robertoostenveld/esp8266_artnet_dmx512/(threads)

Thread 4 (2022-11-02):

i2s includes are case sensitive

apdlv72, 2022-11-02:
I didn't want to create a pull request for this tiny thing.
I noticed that upper/lower case matters when including the i2s header files.
On my Ubuntu 20.04 / Arduino 1.8.16 compilation fails when using upper.
I had to replace it like follows to fix that:
#include <i2s.h>
#include <i2s_reg.h>

robertoostenveld, 2022-11-02:
bummer! In your PR you used lowercase, but I actually got the error with lowercase and had to change to uppercase. This probably relates to us having different operating systems with different ways of dealing with case-sensitive files. I am using macOS.

In https://github.com/esp8266/Arduino/tree/master/libraries/I2S/src and on my computer `./packages/esp8266/hardware/esp8266/3.0.2/libraries/I2S/src/I2S.h` I see that `I2S.h` is  uppercase. That is also the case for the `./packages/SODAQ/hardware/samd/1.8.9/libraries/I2S/src/I2S.h` on my computer.

I also see that the file `./packages/esp8266/hardware/esp8266/3.0.2/tools/sdk/include/i2s_reg.h` is in lowercase. In the code I had that in uppercase, which worked, but now changing it to lowercase also works.

But when I change `I2S.h` into lowercase, I get

```
...
Alternatives for i2s.h: []
ResolveLibrary(i2s.h)
  -> candidates: []
esp8266_artnet_dmx512:92:10: fatal error: i2s.h: No such file or directory
   92 | #include <i2s.h>
      |          ^~~~~~~
compilation terminated.
```

robertoostenveld, 2022-11-02:
The lowercase `i2s_reg.h` is here https://github.com/esp8266/Arduino/tree/master/tools/sdk/include in the original repository.

robertoostenveld, 2022-11-02:
if you only change `i2s_reg.h` into lowercase (as I just did - and pushed), does it then work for you?

apdlv72, 2022-11-02:
Thank you for chasingthis.
Now I found the issue. It had an older version of the esp8266 package as well as I2S library to the newest versions 3.0.2 and 1.2.1 resp. , it compiles with these includes:
#include <I2S.h>
#include <i2s_reg.h>

Closed 2022-11-02.

Thread 6 (2022-11-02):

ESP32 Support

aaron-harvey, 2022-11-02:
I stumbled across your project today and it looks promising!

Have you considered using an esp32 over the 8622?

robertoostenveld, 2022-11-03:
At the time I initially needed this (around [2016/2017](https://robertoostenveld.nl/?s=dmx512)) the ESP32 had just been released, was not widely supported wrt Arduino libraries, and was not very affordable yet. I personally did not have the need to upgrade the few Artnet-to-dmx converters that I built myself, and am not regularly making new ones. That said, if I were now to start from scratch, it is likely that I would use an ESP32 based board.

Considering my code, I don't think that there is much (if any) that is specific to the ESP8266. The WiFi works the same between the ESP32 and the ESP8266, the LEDs are trivial, the serial/UART output should work fine, and the recently introduced I2S should also work on the ESP32. I suggest you just give it a try to see whether it compiles for and executes on an ESP32 board, even without connecting anything to it.

VocasoGK, 2022-11-09:
I've tried compiling the code with Arduino IDE 2.0.1, with DOIT ESP32 DEVKIT V1, and it doesn't compile. I've tried 'fixing' the code since actually don't really know what I'm doing lol.

Change includes:
- Changing #include from ESP8266 to ESP32 equivalent library.
- Adding #include for SPIFFS lib both in .ino and webinterface.cpp
- Commenting #define ENABLE_UART because I don't know the equivalent of "c_types.h" and "eagle_soc.h"
- Changing #include "uart_register.h" to "soc/uart_reg.h", "i2s.h" to "driver/i2s.h", and "i2s_reg.h" to "soc/i2s_reg.h"
- Changing some part of handleDirList() in webinterface.cpp according to ESP32 SPIFFS syntax. (I hope it has the same functionality)
- Commenting some part in webinterface.cpp that uses Update.

Known problems:
- allBlack() not defined
- Update in webinterface.cpp is not defined
- i2s_begin and i2s_set_rate is not declared

It's a pretty advanced code for me, so yeah. I hope we can get ESP32 support soon as it is substantially more powerful, not to mention the external antenna capabilities on some models. :)
Modified code:
[esp8266_artnet_dmx512.zip](https://github.com/robertoostenveld/esp8266_artnet_dmx512/files/9969300/esp8266_artnet_dmx512.zip)

Thread 8 (2023-03-12):

Wired lan

lhvandersteen, 2023-03-12:
Hello.

Is there a option to use a wired connection instead of wireless.

Thank you

robertoostenveld, 2023-03-12:
In principle yes, but then you should implement it with an arduino or other microcontroller board with a wired ethernet interface. Then you would get something similar as https://www.enttec.com/product/din/ethernet-to-dmx-rdm-adapter/

The esp8266 is a wifi microcontroller module and not suited for wired network, so my design is not of use.

lhvandersteen, 2023-03-12:
Hello

Thank you for the quick answer.
Would this also be working
https://www.olimex.com/Products/IoT/ESP32/ESP32-POE-ISO/open-source-hardware

robertoostenveld, 2023-03-12:
Yes, that might work. Or an Arduino Uno with an [Ethernet Shield](https://docs.arduino.cc/retired/getting-started-guides/ArduinoEthernetShield), or an Adafruit Feather with the [FeatherWing](https://www.adafruit.com/product/3201). But none of them will work with the firmware that is in this repository; they all would require a significant rewrite. I think that - at best - 25% of the code in my repository would be reusable, the rest would probably have to be written from scratch.

Closed 2023-03-12.

Thread 9 (2023-03-23):

why use uart

lesleylemmens, 2023-03-23:
Hi, if i2s works better, why do i need to also make the uart connection and the toggle switch?
in wich file do i enable i2s?

robertoostenveld, 2023-03-23:
There have been reports by some that i2s works good for them, by others (including myself) that uart works good for them. It is a choice that you can make. If you add the toggle switch, you can easily compare. Without the toggle switch you'll have to use a soldering iron to switch between the two options.

In line 37 and 46 of [esp8266_artnet_dmx512.ino](https://github.com/robertoostenveld/esp8266_artnet_dmx512/blob/main/esp8266_artnet_dmx512.ino) you can enable/disable the two options. By default both are enabled; this comes at the expense of slightly higher computational load for the microprocessor, so if you know that you will only be using one you can disable the other.

Thread 11 (2023-04-19):

Static IP setting

maximbeliveau, 2023-04-19:
it would be usefull if we can set a static ip for networks without DHCP servers.

robertoostenveld, 2023-04-19:
That could indeed be useful. For that the code on line https://github.com/robertoostenveld/esp8266_artnet_dmx512/blob/57212159923df2f84f8e9a81104d06b9ad493831/esp8266_artnet_dmx512.ino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 and all other lines relating to the WiFimanager would have to be modified into something like this https://randomnerdtutorials.com/esp32-static-fixed-ip-address-arduino-ide/. It would make the code much simpler.

Making it user-friendly and configurable from the web interface however would better be implemented in the https://github.com/tzapu/WiFiManager package. You can check over there whether it is on the wish-list, or make an issue at https://github.com/tzapu/WiFiManager/issues to suggest this.

I have no plans to implement this myself, so I will close this issue. Feel free to fork my repo and make the change yourself.

meowde, 2023-05-16:
Following up, @robertoostenveld just letting you know that it was indeed already implemented in the WiFiManager package. We added, where you pointed :

wifiManager.setSTAStaticIPConfig(IPAddress(192, 168, 0, 101), IPAddress(192, 168, 0, 1), IPAddress(255, 255, 255, 0));
wifiManager.setShowStaticFields(true);

to have a built-in static IP, and also be able to modify that IP in the Manager afterwards. Thank you!

Closed 2023-04-19.

Thread 12 (2023-09-09):

Not able to receive Artnet packets

woutwoot, 2023-09-09:
I've built this device and connected it to a simple par light to test it. (I2S mode)

It looks like everything is working, but it seems somehow I'm not able to have the ESP receive data over ArtNet.
I'm using QLC+ to send data, and it reports 1000s of packets sent, but on the web interface of the ESP I only see a very low number of packets received (around 30, does go up very very slowly over time)
I can tell the light itself is receiving DMX data because it has a blinking led for this.

I would really love to get this to work but at this point I'm not sure if I'm doing something wrong or what it may be. Any clue as to what this issue could be or how I could debug it?

robertoostenveld, 2023-09-09:
I suggest you use the serial monitor in the Arduino IDE to connect to the ESP. On this line https://github.com/robertoostenveld/esp8266_artnet_dmx512/blob/57212159923df2f84f8e9a81104d06b9ad493831/esp8266_artnet_dmx512.ino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 it will print that it receives data and a bit further it will print a counter for the number of Artnet packets received. That should help you to further debug.

robertoostenveld, 2023-09-09:
Oh, and the DMX stream that your fixture receives is sent by the ESP independently of the Artnet that it receives. In the main loop on line https://github.com/robertoostenveld/esp8266_artnet_dmx512/blob/57212159923df2f84f8e9a81104d06b9ad493831/esp8266_artnet_dmx512.ino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 and a bit further it sends the data of the whole universe over the serial interface, at a fixed rate. The ‎onDmxPacket‎() function only runs when an UDP packet is received and it updates the universe data.

woutwoot, 2023-09-10:
@robertoostenveld Thank you for pointing me in the right direction. Of course it was something stupid, I was using Artnet universe 0 in QLC+ and universe 1 is what my light setup was responding to. As soon as the two matched things worked.
Thank you for this project!

woutwoot, 2023-09-10:
Hmm, is it possible that somehow addresses are also shifted by one? My fixture starts at 1 but it seems my first channel is shifted one up in practice. Guess that's something on my end as well but just making sure :)

robertoostenveld, 2023-09-11:
With the numbered universes and channels it can be challenging to deal with the numbering sometimes starting at 0, and sometimes at 1. Glad you figured it out and have fun with it!

Closed 2023-09-10.

Thread 13 (2023-10-12):

Problem uploading web page

lightsun1323, 2023-10-12:
After uploading the project, I encountered the problem that none of the web pages in the data folder were uploaded, except for the ones in the photo below.
Where do you think the problem comes from?
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

robertoostenveld, 2023-10-15:
As long as you see this, it is not connected to wifi and it remains basically stuck in the `setup()` function around https://github.com/robertoostenveld/esp8266_artnet_dmx512/blob/57212159923df2f84f8e9a81104d06b9ad493831/esp8266_artnet_dmx512.ino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

I am not exactly sure at which line it blocks, but it won't get  to https://github.com/robertoostenveld/esp8266_artnet_dmx512/blob/57212159923df2f84f8e9a81104d06b9ad493831/esp8266_artnet_dmx512.ino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 where the webserver with all other pages is initiated.

Have you connected the ESP8266 over the serial/usb port to your computer. If you use the Arduino serial monitor, you can follow in much more detail what happens in the code with the `Serial.println()` lines.

Thread 14 (2023-10-12):

Changing the base of the signal output

lightsun1323, 2023-10-12:
I am using esp8266-07 and after uploading the RX base project, it is the output base
I want to make changes so that the TX base is the DMX output base
I changed the LED bases according to what I want, but I did not find the DMX output base
Is such a thing possible or not?

robertoostenveld, 2023-10-15:
I am not really sure what you mean with "base", it is not a term that I am familiar with in relation to this microcontroller or the arduino environment.

There are two modes of operation, either it uses the serial UART1 through `Serial1` (when `ENABLE_UART` is defined, see line 37), or it uses I2S which is the sound interface (when `ENABLE_I2S` is defined, see line 46).

See http://arduino.esp8266.com/Arduino/versions/2.3.0/doc/reference.html#serial for documentation on the serial interface.

If you don't want to use UART1, I suggest you use the I2S interface. That is explained [here](https://github.com/robertoostenveld/esp8266_artnet_dmx512/blob/main/README.md#i2s).

I should add that I have implemented this for a Wemos D1 mini board and only tested that and a NodeMCU module. The ESP-07 is a more bare module that seems to have fewer pins exposed. The sketch may need changes to accommodate
that.

lightsun1323, 2023-10-15:
Forgive me for my wrong translation
By the base, I mean the pin
I defined all the pins for esp07 and the project is running well
The only problem I have is that the RX pin is recognized as an output on I2S, and no matter what I did, I could not change it to the TX pin.

Regards
Sami

robertoostenveld, 2023-10-15:
There is no dedicated pin for I2S (see https://docs.espressif.com/projects/esp-idf/en/latest/esp32/api-reference/peripherals/i2s.html), but in my sketch it is set to pin GPIO 3, which is indeed Rx.

See
https://github.com/robertoostenveld/esp8266_artnet_dmx512/blob/57212159923df2f84f8e9a81104d06b9ad493831/esp8266_artnet_dmx512.ino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

As far as I know, you can change it to whatever you like and hence use another pin for I2S.

robertoostenveld, 2023-10-15:
On https://randomnerdtutorials.com/esp8266-pinout-reference-gpios/ there is a section that discusses what the best pins are for certain purposes. You could check there to see which of your ESP-07 pins are still available and are the best suited for output without interfering with other functions.

lightsun1323, 2023-10-15:
I looked at the links you sent
And by changing the number of the pin, nothing happens inside the output and only the RX pin gives the DMX output, even with the number changed
I erase esp07 flash memory with python for each test
I even tested it on the NodeMCU board, but nothing happens by changing the pin and compiling, and even by putting a different number (1, 2, 3, ...), only the RX pin outputs.

lightsun1323, 2023-10-18:
I looked at the links you sent
And by changing the number of the pin, nothing happens inside the output and only the RX pin gives the DMX output, even with the number changed
I erase esp07 flash memory with python for each test
I even tested it on the NodeMCU board, but nothing happens by changing the pin and compiling, and even by putting a different number (1, 2, 3, ...), only the RX pin outputs.

robertoostenveld, 2023-10-20:
I am not sure how you are testing this, do you have a DMX light fixture attached to the ESP, or are you looking with an oscilloscope?  "Nothing happens" (as you write) can be because of a lot of different reasons when you change something, for example because nothing happened to start with.

 I recommend that you make a very simple schematic like a [blink](https://www.arduino.cc/en/Tutorial/BuiltInExamples/Blink) sketch and implement that with the different ways of outputting a PWM series of pulses (which is similar to what the DMX protocol does) and look at that with an LED over a resistor.

Thread 16 (2024-03-10):

no dmx data received by led par

wannabeadjeo, 2024-03-10:
I am using the i2s to send the dmx data to my par, and I wired the di pin to the Rx pin on my nodemcu esp8266, the gnd and re pin on the nodemcu gnd pin, and the vcc to the vv pin on my node mcu. I configured it on the web server, the artnet universe is univ1, the same on my qlc+, the channels are 512, the delay is 25, yet my par is not responding, but if I use my usb to dmx interface, it is working properly.
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

robertoostenveld, 2024-03-10:
Did you try it with the UART mode? Do you have the possibility to connect the output to an oscilloscope to see whether you see a signal?

wannabeadjeo, 2024-03-11:
> Did you try it with the UART mode? Do you have the possibility to connect the output to an oscilloscope to see whether you see a signal?

The problem is that I don't have an oscilloscope to use. I have a question: if I will use the UART mode, do I need to put the di pin on the D4 instead of the tx pin on my Nodemcu?

wannabeadjeo, 2024-03-11:
Sir, you can close this issue. I have found the solution; I just swapped my RS485 module.

robertoostenveld, 2024-03-11:
That is nice to hear, have fun with the DMX converter!

wannabeadjeo, 2024-03-11:
> That is nice to hear, have fun with the DMX converter!

Thank you so much for answering me

Closed 2024-03-11.
