robertoostenveld/esp8266_artnet_dmx512/(commit log)

2017-04-17 first working version of Artnet-DMX512 relay, mpstly based on esp8266_artnet_neopixel
2017-04-17 added some comments to the code, updated RGB led pins
2017-04-20 added configuration option for numbver of channels and for delay between sending of DMX frames (was 512 and 25). With smaller values (e.g. 8 channels, 10ms delay) the responsiveness of my test DMX fi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
    [esp8266_artnet_dmx512.ino]
2017-05-26 better description of led colors
2017-06-08 RE should go to ground
    thanks to Silvano for reporting
2017-08-05 Added an option to use a common anode RGB LED.
2017-08-22 Added C++ code to generate the break on the uart. Initialize the WiFi hostname before starting the network.
2017-11-04 include enclosure, barrel connector and wiring for RGB led in documentation
2017-11-04 removed the LDO regulator
    It is not used in the final design, since the Wemos D1 mini 5V pin can be used
2018-06-12 fixed small typo in a comment
    [esp8266_artnet_dmx512.ino]
2019-09-18 * update ArduinoJson version 5 => 6
2022-09-24 add VCC-to-3.3V for the MAX485 module, reformatted a bit
2022-09-26 Added test code and fixed issues
    [esp8266_artnet_dmx512.ino]
2022-09-27 Update esp8266_artnet_dmx512.ino
    Enabled UART, disabled I2S by default
2022-10-31 merged non-repeating code for I2S and UART into main sketch
2022-10-31 moved status LED handling to separate files
2022-10-31 code cleanup, this commit should not have any major functional changes
    - put code inline where possible
    - avoid functions that are called only once
    - reordered conditional sections of code
    - moved LED handling to separate files
    - renamed setup_ota to webserver
    [esp8266_artnet_dmx512.ino]
2022-10-31 added schematic from https://github.com/robertoostenveld/esp8266_artnet_dmx512/pull/1
2022-11-02 Updated schematic and Readme
2022-11-02 Fixed pin name
2022-11-02 Fixed i2s includes. Simplified rgb_led.cpp
    [esp8266_artnet_dmx512.ino]
2022-11-02 fix #4 - include i2s_reg.h as lowercase file name
    [esp8266_artnet_dmx512.ino]
2022-11-02 Fixed i2s case sensitivity issue
    [esp8266_artnet_dmx512.ino]
2024-02-25 ENH - make explicit that N_JSON_TO_CONFIG, N_CONFIG_TO_JSON, and N_KEYVAL_TO_CONFIG are for numbers
    - there are corresponding S_ versions for strings
    - removed/moved header includes for consistency
    - warn in readme that Arduino IDE 2.x cannot write SPIFFS
2024-03-02 ENH - avoid redirects to make the webinterface faster
    - use server.onNotFound(handleNotFound) for all regular html files, including settings, monitor and hello
    [esp8266_artnet_dmx512.ino, webinterface.cpp]
2024-03-02 ENH - improved consistency
    - wait 5 seconds after reset so that success+reload completes
    - use ESP.restart instead of reset
    - renamed initialConfig to defaultConfig
    - "reset" via webinterface (now restart) only restarts, does not change wifi or settings
    - "defaults" only updates the settings, not the wifi
    - "reconnect" via webinterface only updates the wifi settings
    [esp8266_artnet_dmx512.ino, webinterface.cpp, webinterface.h]
2025-03-23 convert number to float, not int
    - "Save" instead of "Send" on button in config web interface
